Aidenbolos/Green-Sense/Images/bme_680bb_setup.jpg

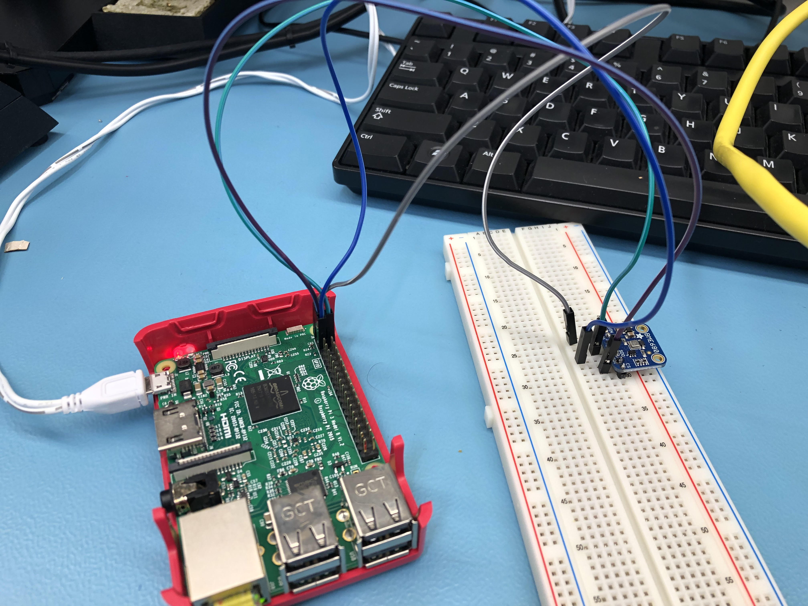
Images/bme_680bb_setup.jpg
