Aidenbolos/Green-Sense/Images/Greenhouse Frame/GreenhouseFrameStep3.jpg

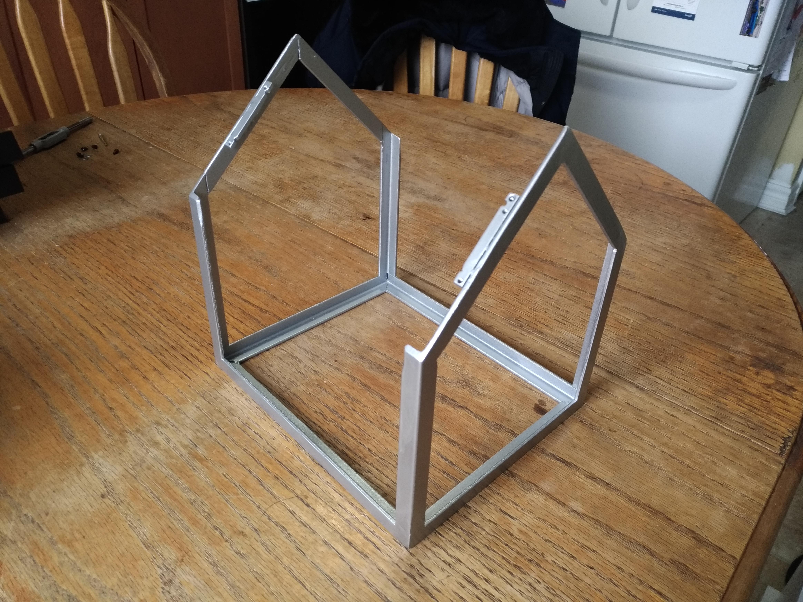
Images/Greenhouse Frame/GreenhouseFrameStep3.jpg
