Aidenbolos/Green-Sense/Documents/CENG 319/Meeting2Report.docx

GreenSense – RAD Technologies (Ryan, Aiden, Daniel)

CENG 319 Project – Milestone 3

Contact: Valeria from Humber Greenhouse

October 16, 2019

Second Meeting Minutes

- Returned the Argus Controls user manual that she loaned us
- Showed Valeria our PowerPoint presentation from milestone 2 (project plan, design documents, mockups, app demo)
- Valeria was pleased with the current progress and direction we are headed in
- She says we seem to have a good understanding of the greenhouse’s needs
- She liked the option to login as a staff member for a full featured app, or login as a guest for education/information
- She liked that our app is currently user friendly and easy to navigate
- She also had a few suggestions:
1. Have greenhouse 1 and greenhouse 2 accessible from within the same page instead of being separate activities (maybe use TabLayout or BottomNavigation to switch between them)
2. Have sensor readings and effector controls within the same page instead of being separate activities
3. Add the Humber logo/colour scheme somewhere within the app/main screen (this is something to consider for other college’s/greenhouses as well)
- She is looking forward to meeting again and seeing our progress
- We thanked her for her suggestions and will meet again soon
