Aidenbolos/Green-Sense/Documents/CENG 319/Current Work Progress Report.docx

Current Work Progress Report

(R.A.D. Technologies Greenhouse System Project)

As of the first milestone (October 8th, 2019) our current progress on the project has been as follows:

- Had first meeting with sponsor; Valeria from the Humber Greenhouse
- Established a name and icon for the application
- Multiple resolutions for the icon and other images used
- Entry level mockups completed
- Requirement Analysis completed
- Defined current tools that have been used and/or tools that will be used
- We have a minimum of 3 java classes started
- The current version of the app runs on a device and an emulator
- Completed report from the first meeting with the sponsor
- We have a completed Project Plan and Gantt Chart
- Completed Design documents and Architecture Diagrams

We have plans to start working and developing the app for future releases as well as to start setting up a backend system that will eventually read in data from our sensors from the hardware of the unit to allow for real time, accurate readings of a greenhouse system.
