Aidenbolos/Green-Sense/Mechanical/Greenhouse Frame/GreenhouseFrameSketches.pdf

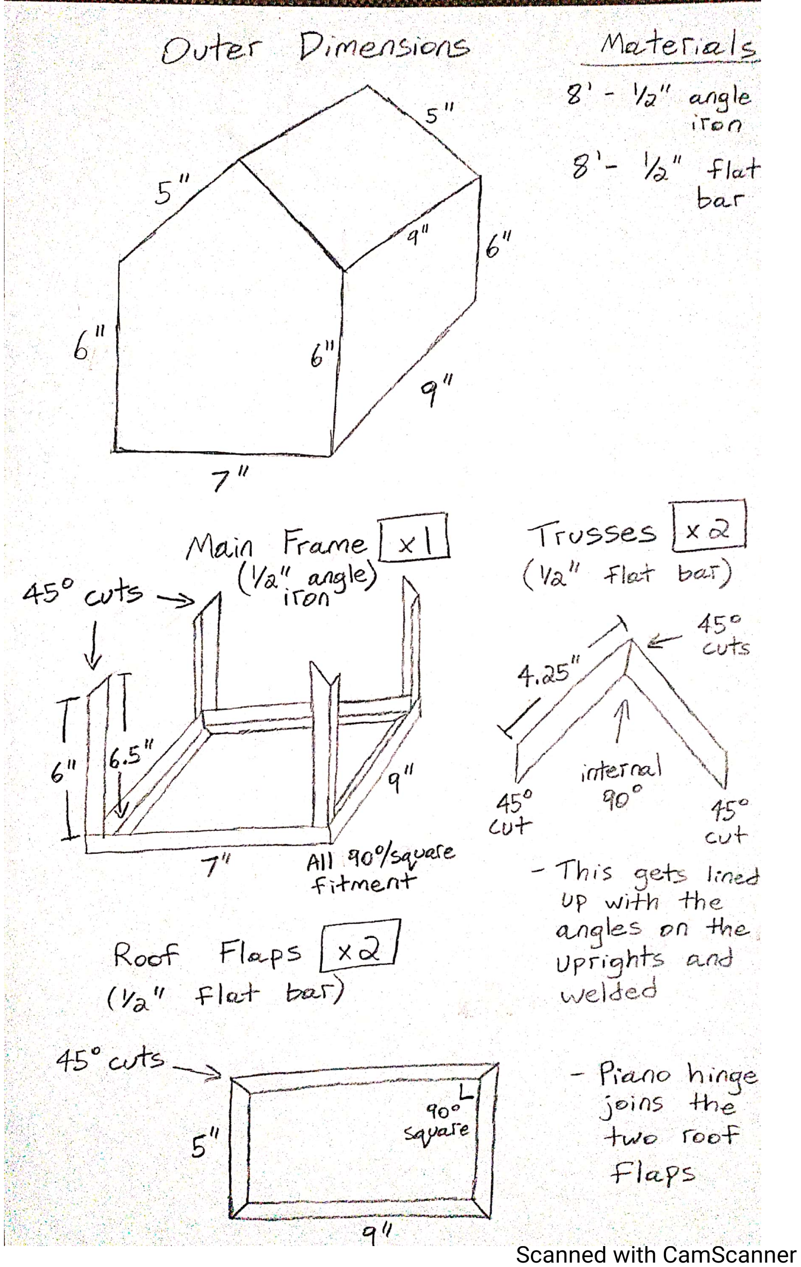
[picture p29: page 1]
