Aidenbolos/Green-Sense/GreenSenseApp/src/main/ic_launcher-web.png

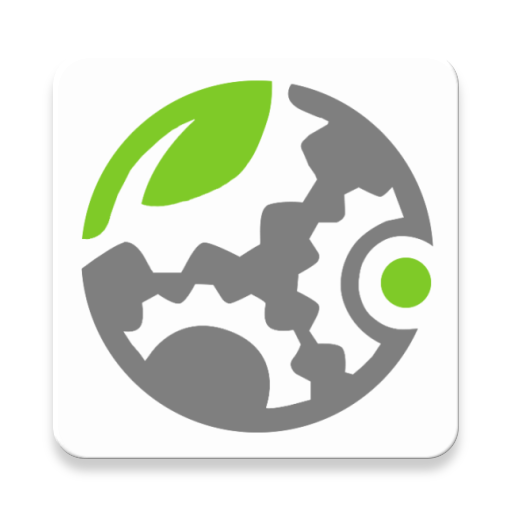
GreenSenseApp/src/main/ic_launcher-web.png
