Aidenbolos/Green-Sense/Images/AppControlScreen2020.PNG

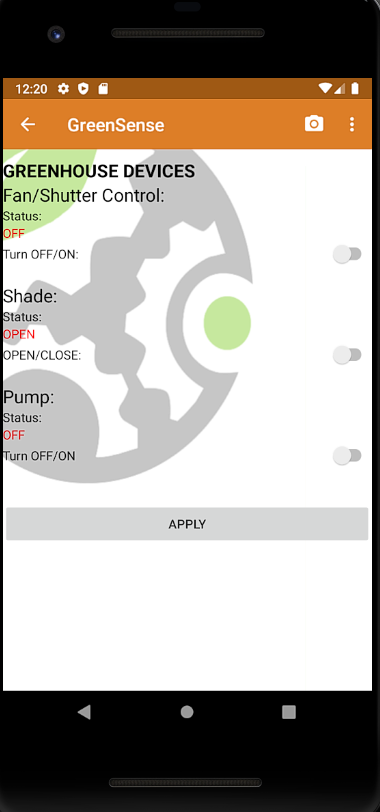
Images/AppControlScreen2020.PNG
