Aidenbolos/Green-Sense/Images/AppMainScreen2020.PNG

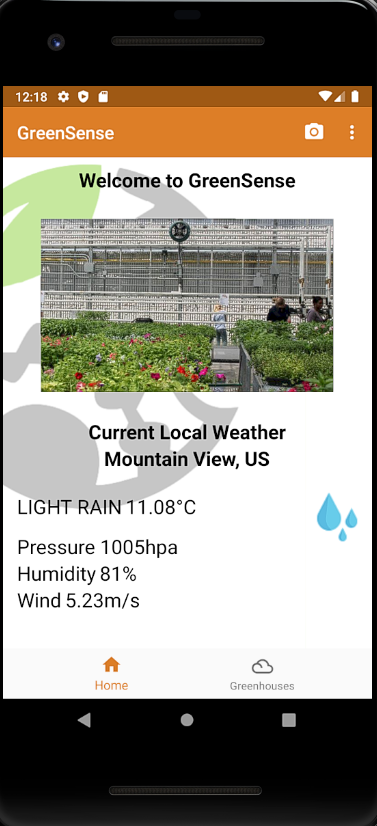
Images/AppMainScreen2020.PNG
