Aidenbolos/Green-Sense/Images/AppReadingsScreen2020.PNG

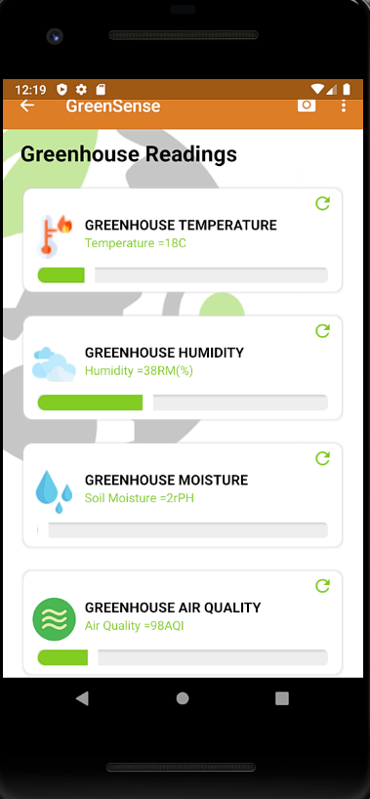
Images/AppReadingsScreen2020.PNG
