Aidenbolos/Green-Sense/Images/AppViewScreen2020.PNG

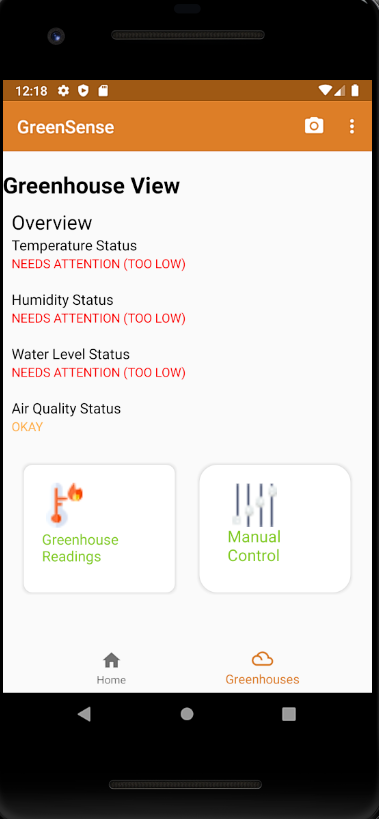
Images/AppViewScreen2020.PNG
