Aidenbolos/Green-Sense/Images/BME680_pcb.png

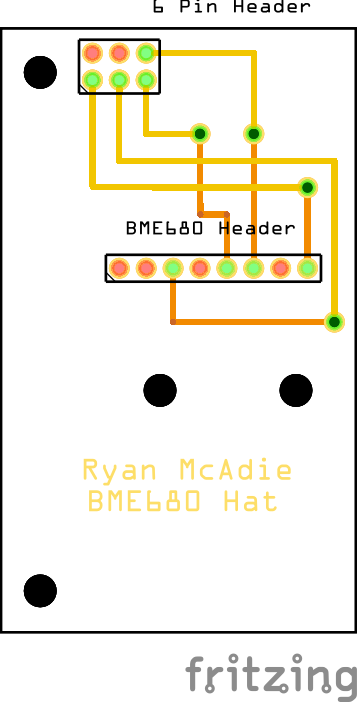
Images/BME680_pcb.png
