Aidenbolos/Green-Sense/Images/Greenhouse Frame/GreenhouseRoof1.jpg

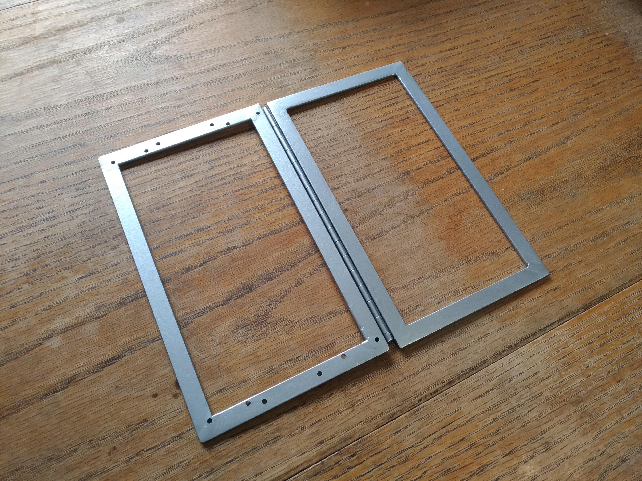
Images/Greenhouse Frame/GreenhouseRoof1.jpg
