Aidenbolos/Green-Sense/Images/Greenhouse Frame/GreenhouseRoof2.jpg

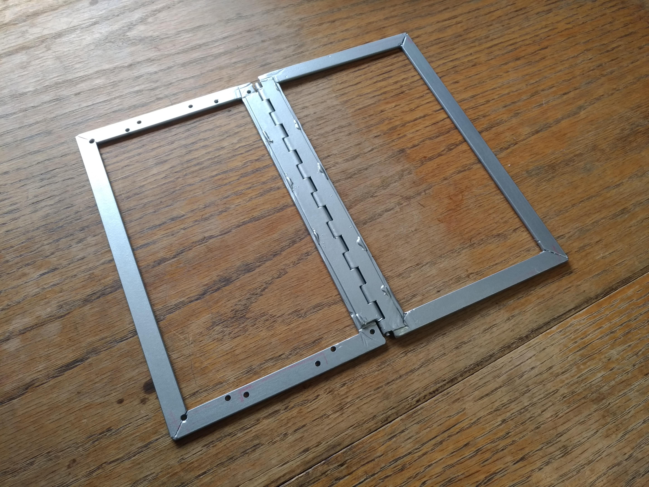
Images/Greenhouse Frame/GreenhouseRoof2.jpg
