Aidenbolos/Green-Sense/Images/Greenhouse Frame/GreenhouseRoof3.jpg

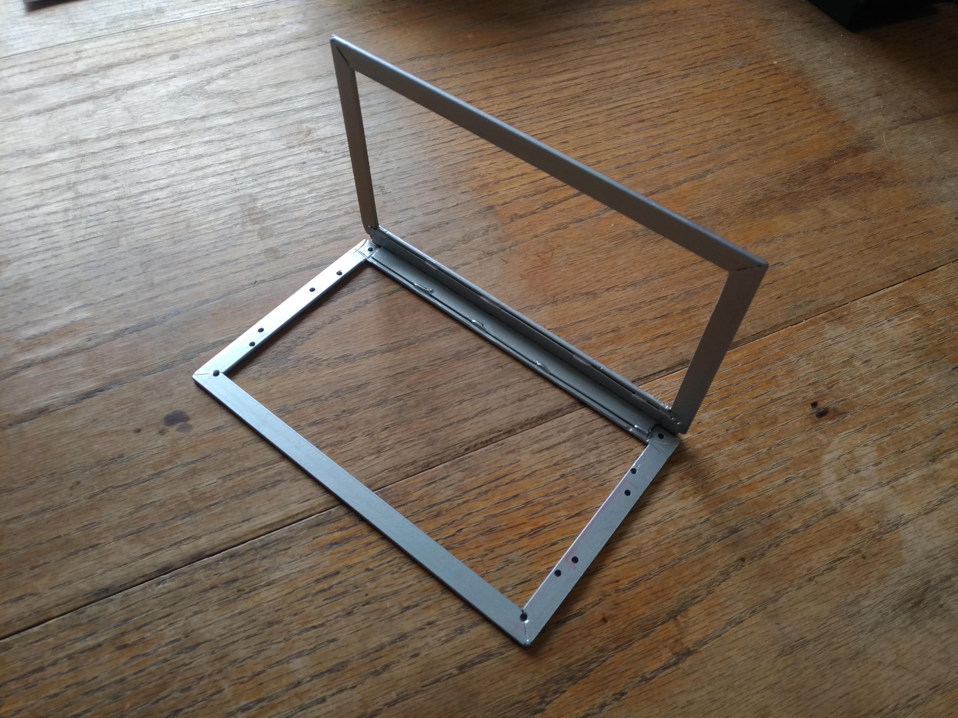
Images/Greenhouse Frame/GreenhouseRoof3.jpg
