Aidenbolos/Green-Sense/Images/GreenSenseCollabFinal_pcb.png

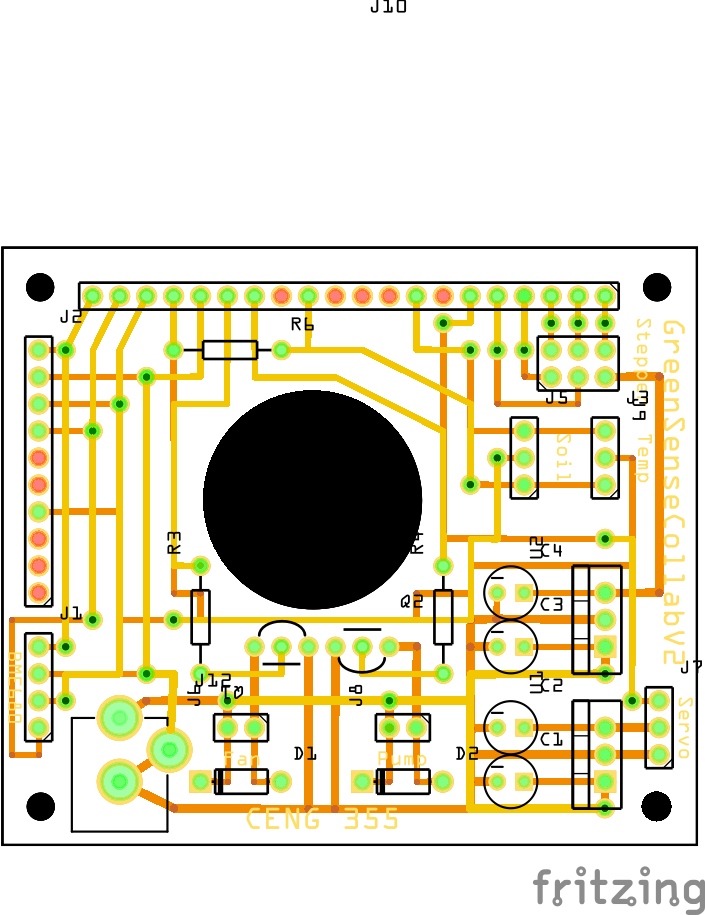
Images/GreenSenseCollabFinal_pcb.png
