Aidenbolos/Green-Sense/Images/GreenSenseSideboard_pcb.png

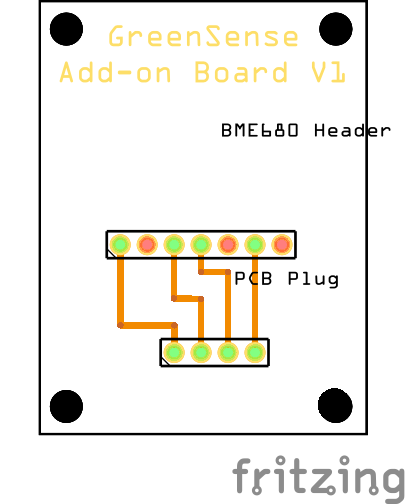
Images/GreenSenseSideboard_pcb.png
