Aidenbolos/Green-Sense/Images/Mockups/2.jpg

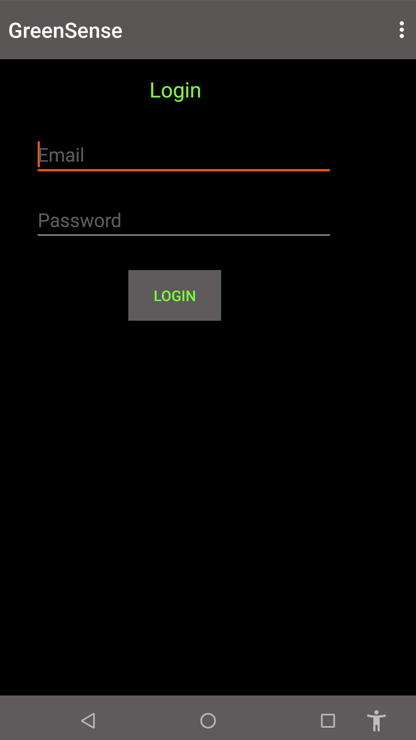
Images/Mockups/2.jpg
