Aidenbolos/Green-Sense/Images/Mockups/3.jpg

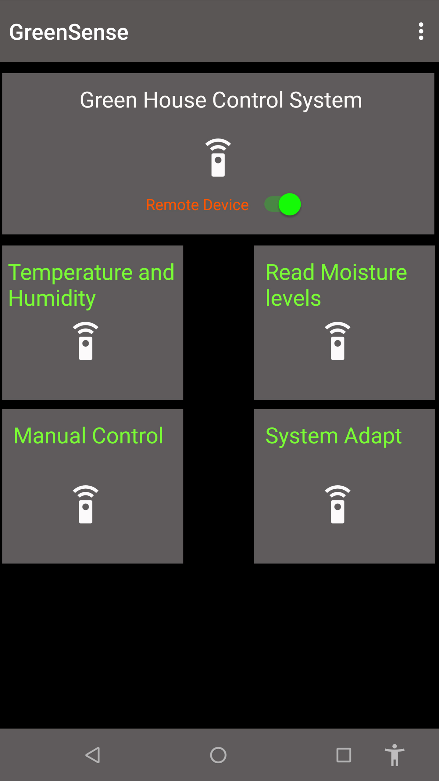
Images/Mockups/3.jpg
