Aidenbolos/Green-Sense/Images/Mockups/4.jpg

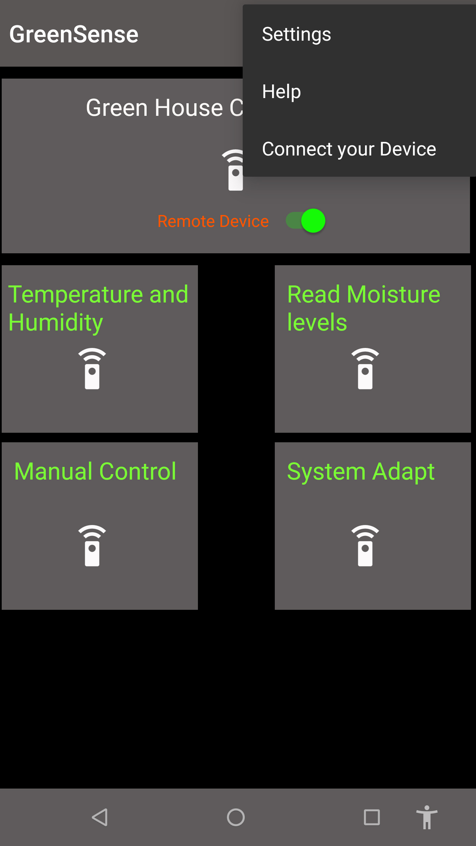
Images/Mockups/4.jpg
