Aidenbolos/Green-Sense/Images/Mockups/5.jpg

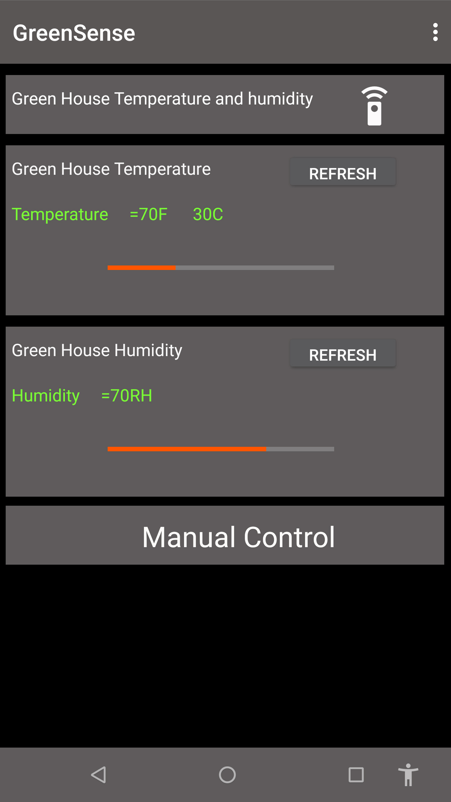
Images/Mockups/5.jpg
