Aidenbolos/Green-Sense/Images/Mockups/6.jpg

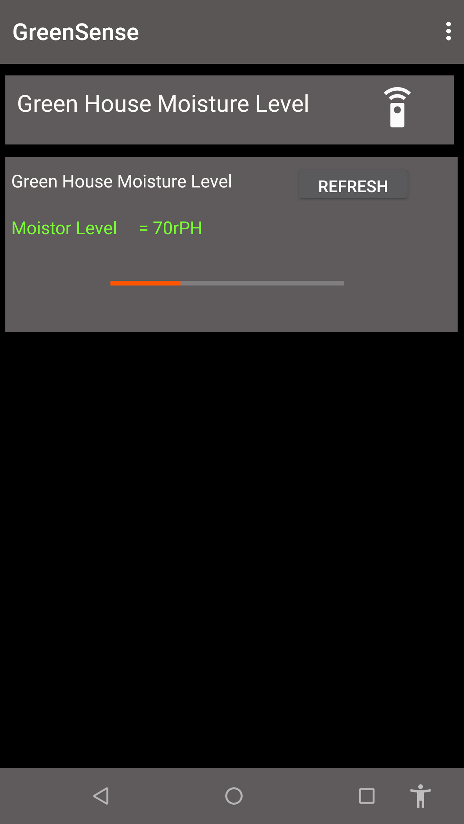
Images/Mockups/6.jpg
