Aidenbolos/Green-Sense/Images/Mockups/7.jpg

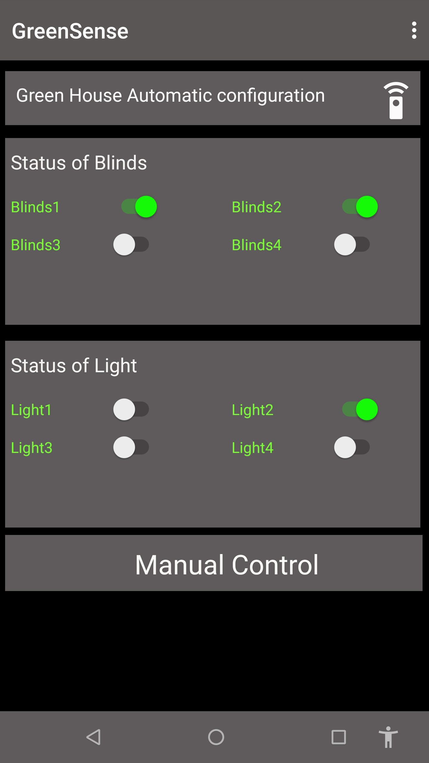
Images/Mockups/7.jpg
