Aidenbolos/Green-Sense/Images/Mockups/8.jpg

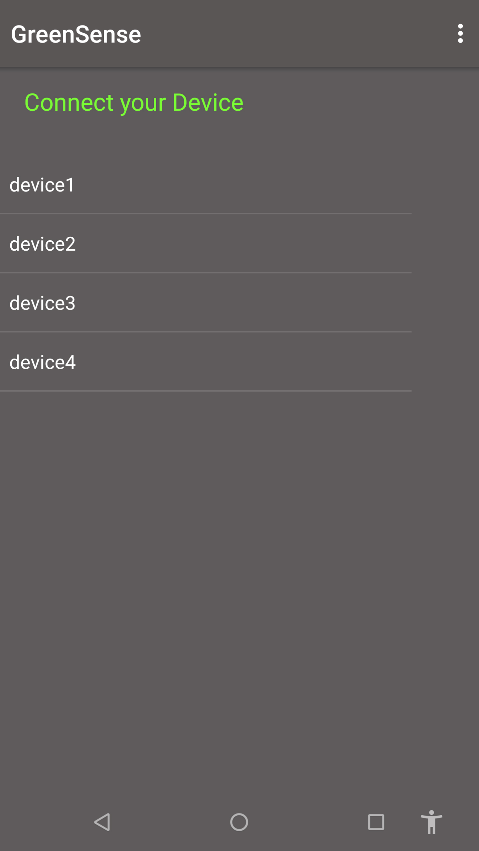
Images/Mockups/8.jpg
