Aidenbolos/Green-Sense/Images/Pi Case + PCB/pcb_sideview.jpg

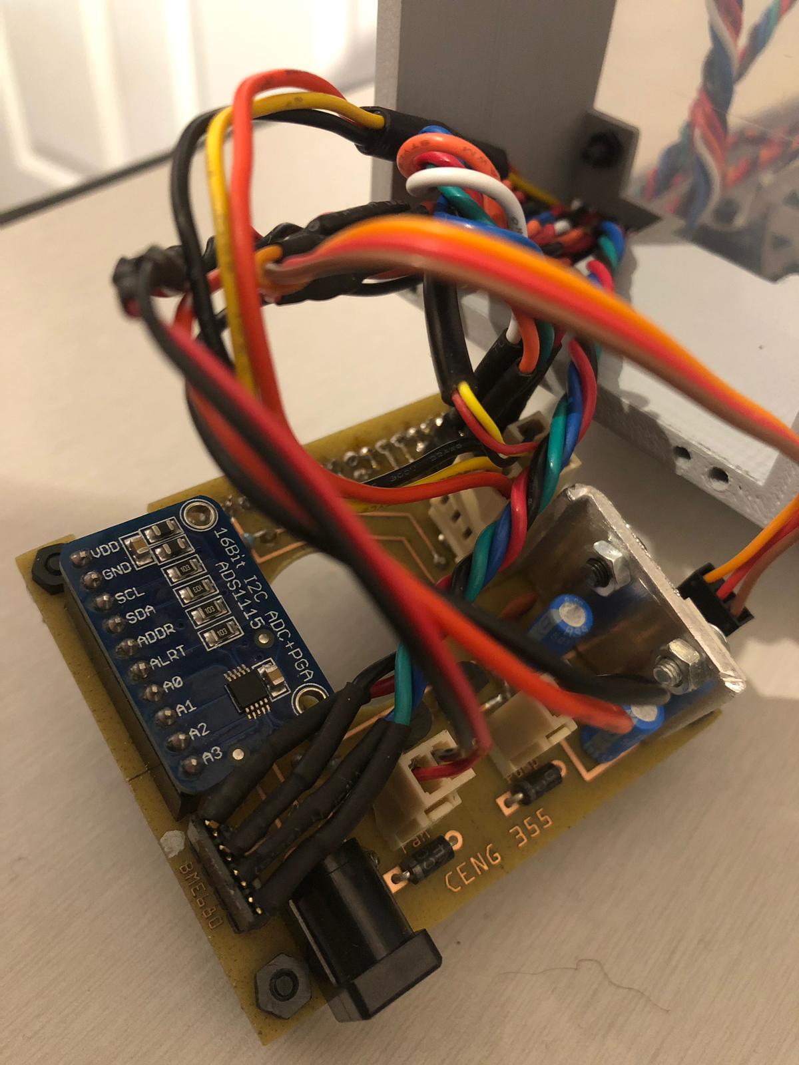
Images/Pi Case + PCB/pcb_sideview.jpg
