Aidenbolos/Green-Sense/Images/Pi Case + PCB/pcb_topview.jpg

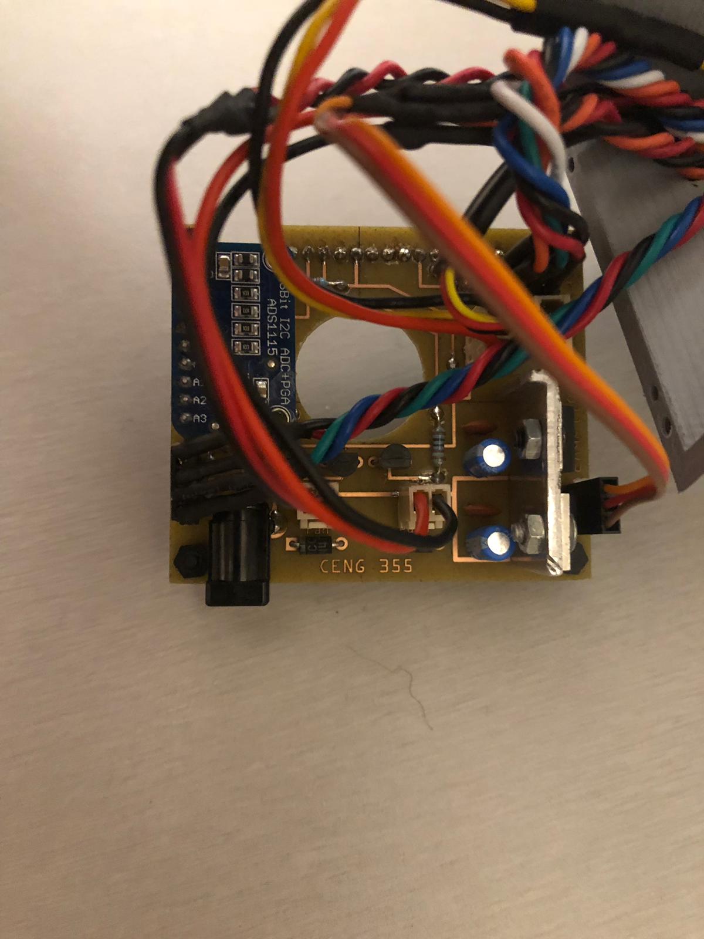
Images/Pi Case + PCB/pcb_topview.jpg
