Aidenbolos/Green-Sense/Images/Pi Case + PCB/pi_case_top.jpeg

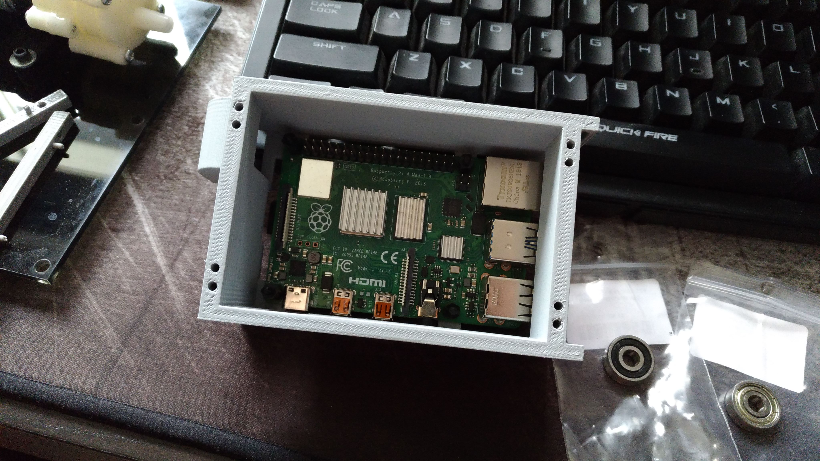
Images/Pi Case + PCB/pi_case_top.jpeg
