Aidenbolos/Green-Sense/Images/Shade System/bearing_mounts.jpg

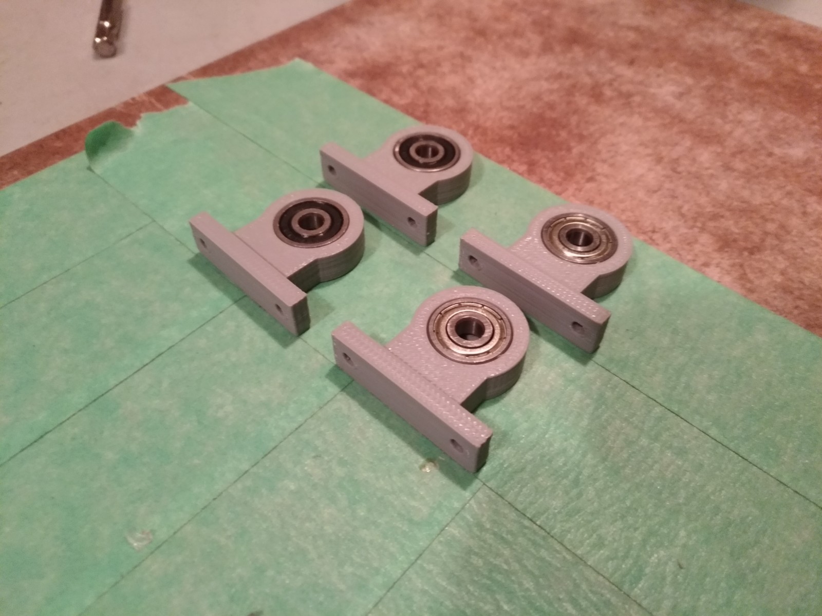
Images/Shade System/bearing_mounts.jpg
