Aidenbolos/Green-Sense/Images/Shade System/stepper_housing_closed.jpeg

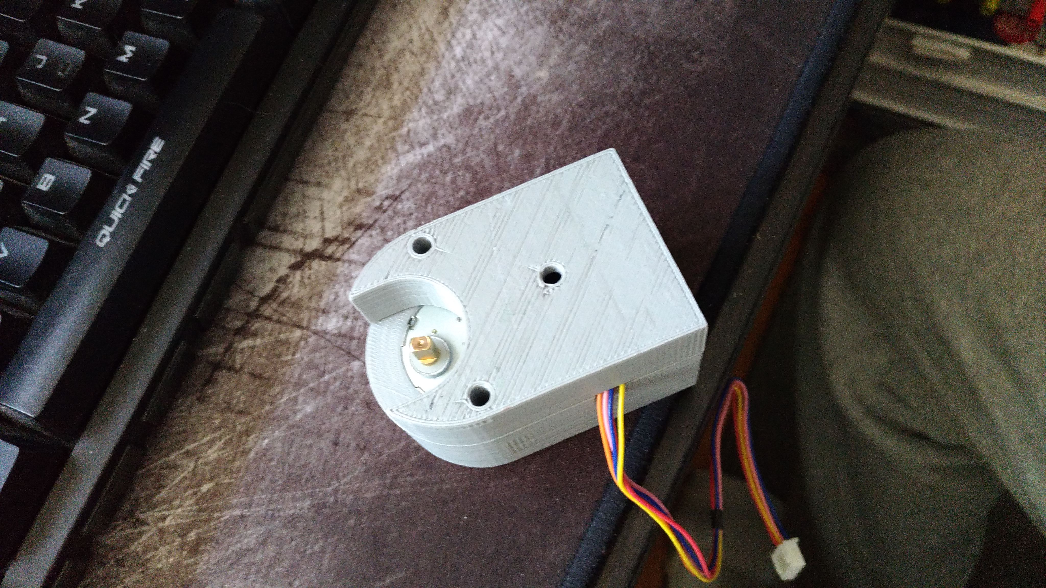
Images/Shade System/stepper_housing_closed.jpeg
