Aidenbolos/Green-Sense/Images/Shade System/stepper_housing_open.jpeg

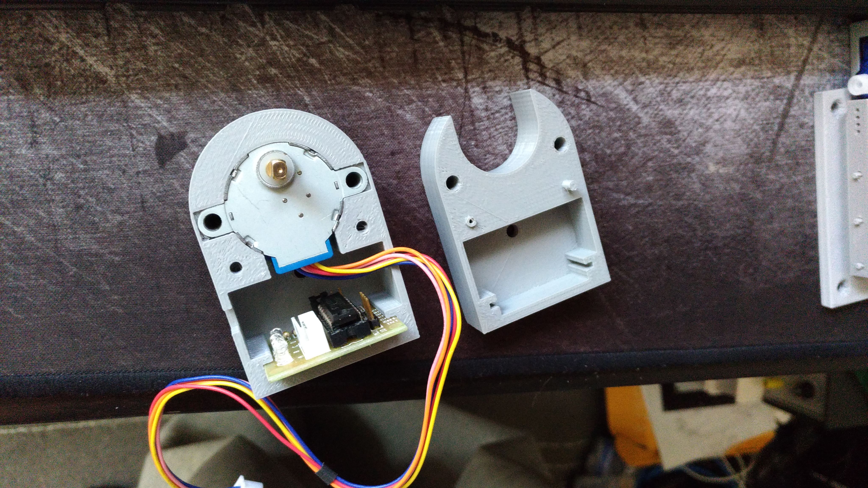
Images/Shade System/stepper_housing_open.jpeg
