Aidenbolos/Green-Sense/Images/Shutter System/pi_case+shutter.jpg

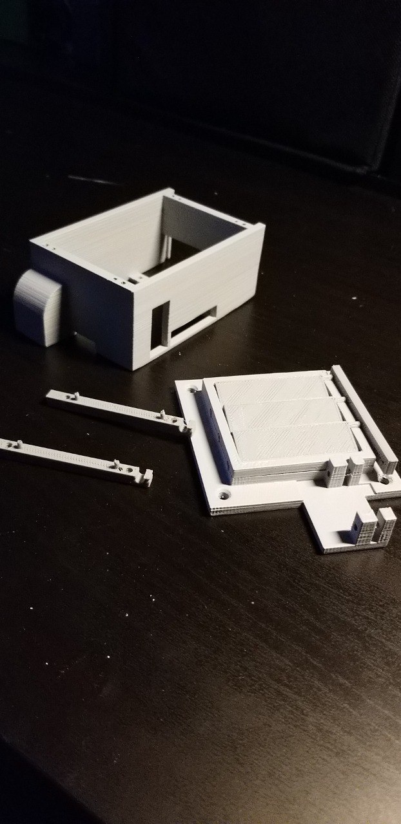
Images/Shutter System/pi_case+shutter.jpg
