Aidenbolos/Green-Sense/Images/Shutter System/shutter_servo.jpg

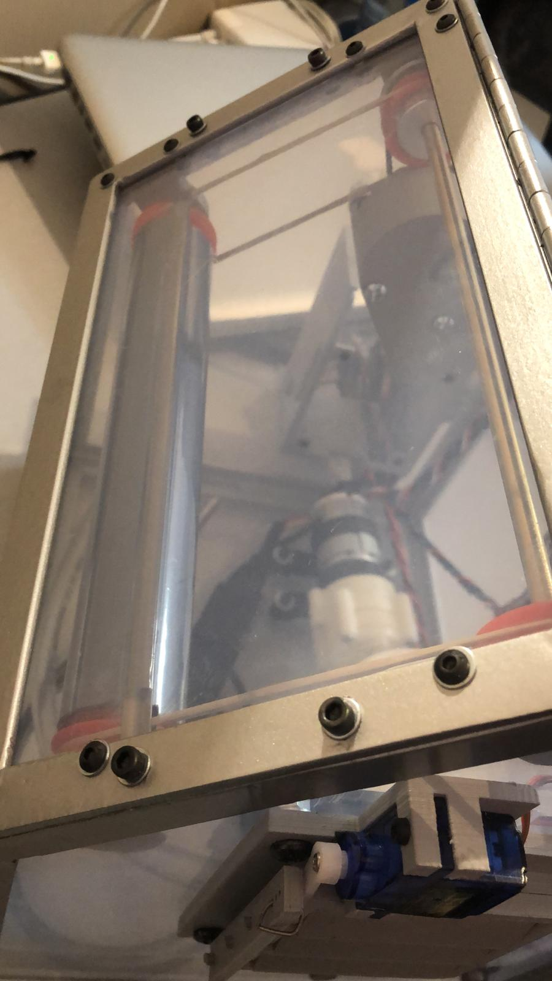
Images/Shutter System/shutter_servo.jpg
