Aidenbolos/Green-Sense/Mechanical/Fan Shroud/FanShroud (complete view).stl

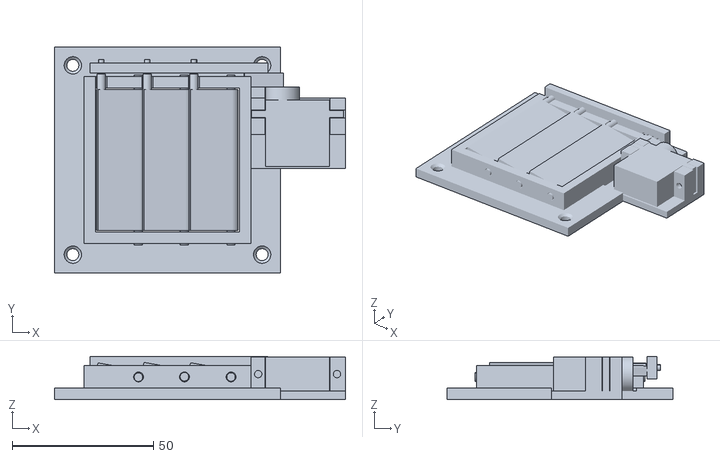
[picture p56: CAD file, 2020-03-15]
Mechanical/Fan Shroud/FanShroud (complete view).stl
103.0 x 80.0 x 15.2
