Aidenbolos/Green-Sense/Mechanical/5mm Bearing Mounts/BearingMounts.stl

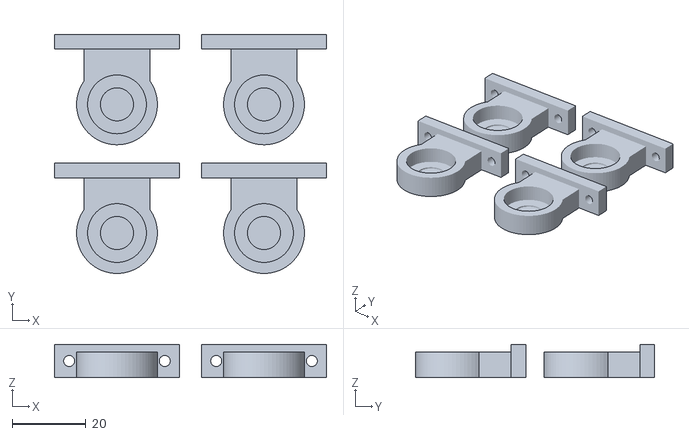
[picture p57: CAD file, 2020-03-19]
Mechanical/5mm Bearing Mounts/BearingMounts.stl
74.0 x 65.0 x 9.00
