Aidenbolos/Green-Sense/Mechanical/Fan Shroud/FanMechParts (for printing).stl

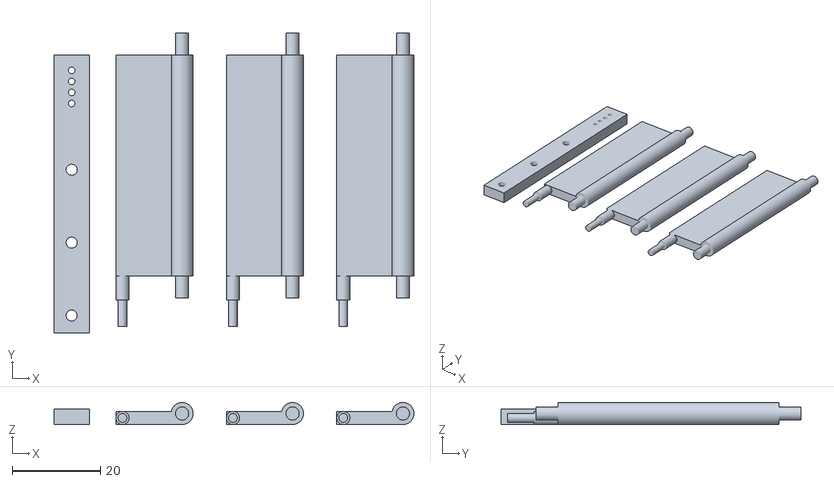
[picture p58: CAD file, 2020-03-15]
Mechanical/Fan Shroud/FanMechParts (for printing).stl
81.5 x 68.0 x 5.00
