Aidenbolos/Green-Sense/Mechanical/Pi Case/GreenSensePiCaseCaps.stl

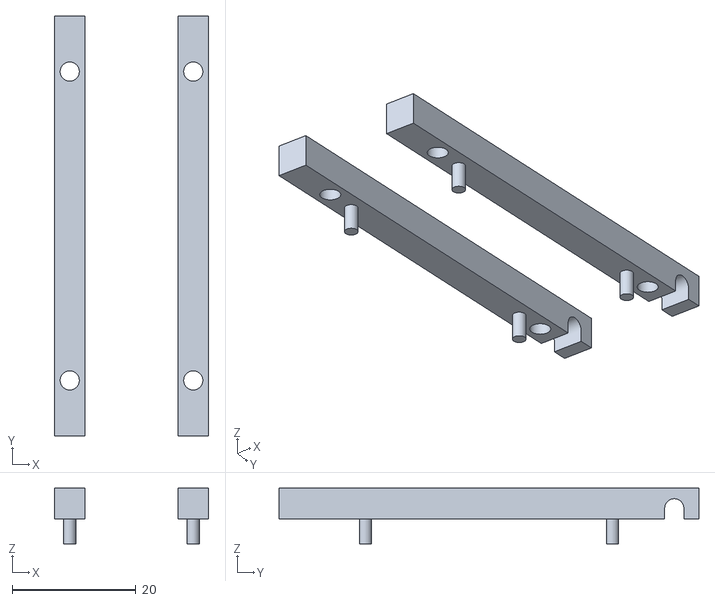
[picture p59: CAD file, 2020-03-17]
Mechanical/Pi Case/GreenSensePiCaseCaps.stl
25.0 x 68.0 x 9.00
