Aidenbolos/Green-Sense/Mechanical/Stepper Motor Mount/StepperMotorMount.stl

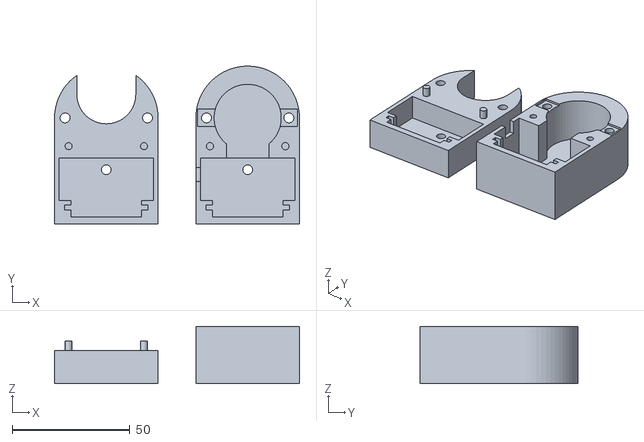
[picture p60: CAD file, 2020-03-19]
Mechanical/Stepper Motor Mount/StepperMotorMount.stl
104.0 x 67.0 x 24.2
