Aidenbolos/Green-Sense/Mechanical/Pi Case/GreenSensePiCase.stl

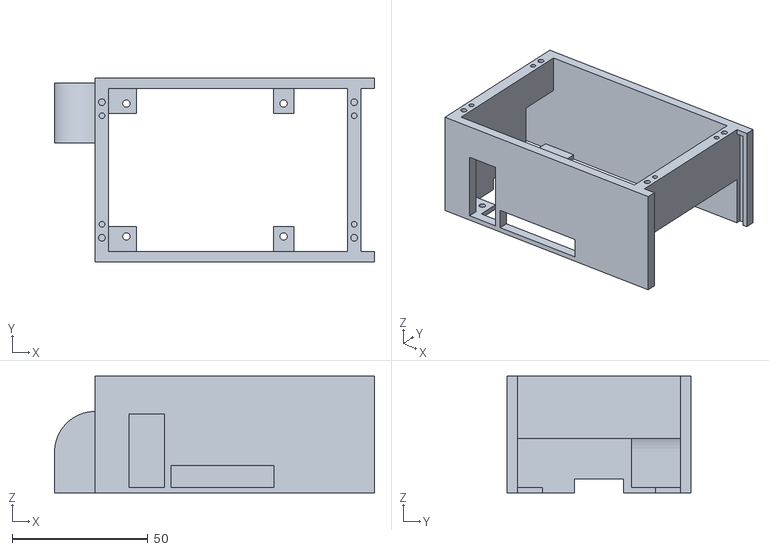
[picture p61: CAD file, 2020-03-17]
Mechanical/Pi Case/GreenSensePiCase.stl
118.0 x 68.0 x 43.0
