Aidenbolos/Green-Sense/Mechanical/Fan Shroud/FanShroudParts (for printing).stl

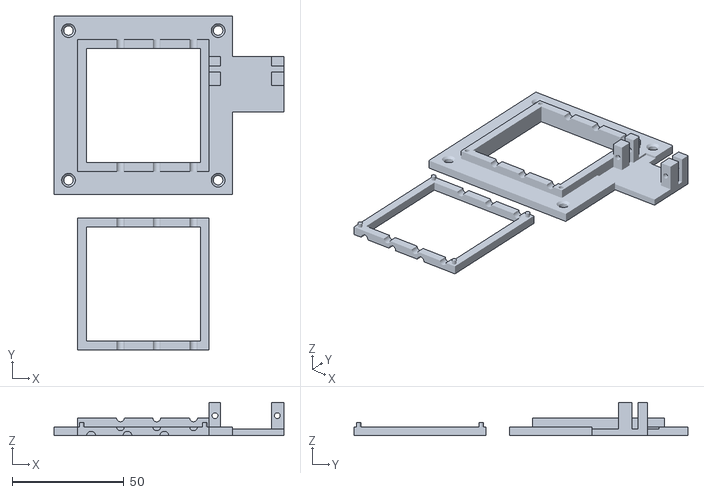
[picture p62: CAD file, 2020-03-15]
Mechanical/Fan Shroud/FanShroudParts (for printing).stl
103.0 x 149.5 x 15.0
