Aidenbolos/Green-Sense/(list of files, cad)

Other CAD files:
Mechanical/Fan Shroud/FanShroudParts.scad
