Aidenbolos/Green-Sense/Images/Greenhouse Frame/GreenhouseFrameStep1.jpeg

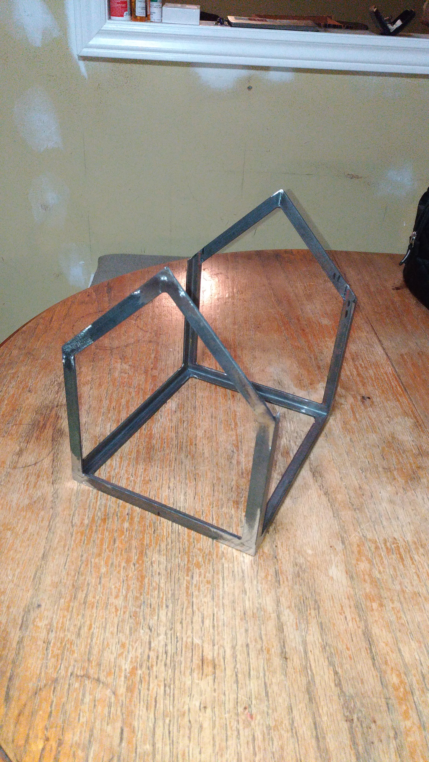
Images/Greenhouse Frame/GreenhouseFrameStep1.jpeg
