Aidenbolos/Green-Sense/Images/Greenhouse Frame/GreenhouseFrameStep4.jpg

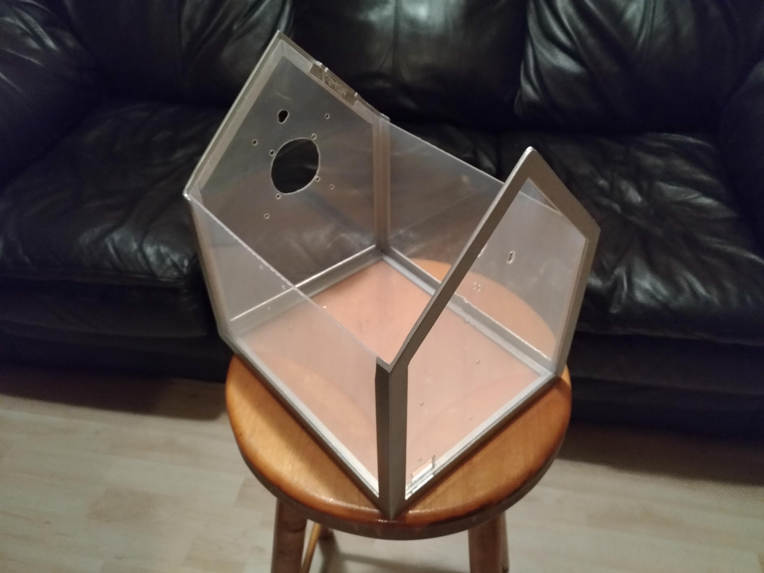
Images/Greenhouse Frame/GreenhouseFrameStep4.jpg
