Aidenbolos/Green-Sense/Images/Greenhouse Frame/GreenhouseFrameStep5.jpg

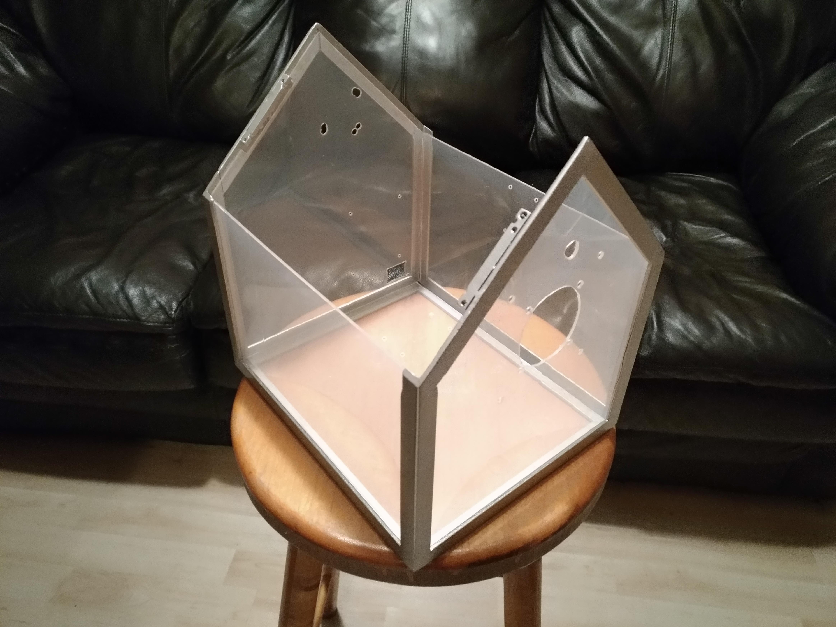
Images/Greenhouse Frame/GreenhouseFrameStep5.jpg
