Aidenbolos/Green-Sense/Images/1kResistor-Test.jpg

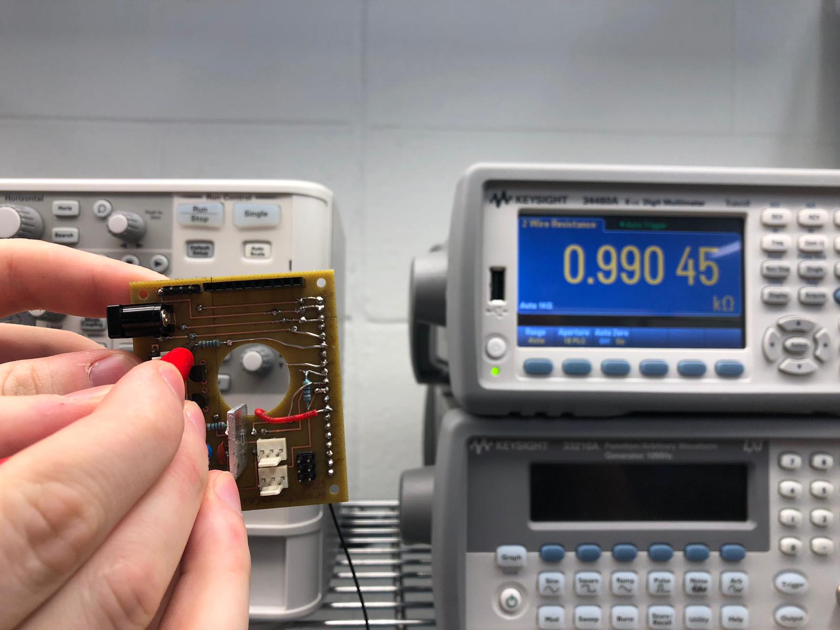
Images/1kResistor-Test.jpg
