Aidenbolos/Green-Sense/Images/3v3Power-Test.jpg

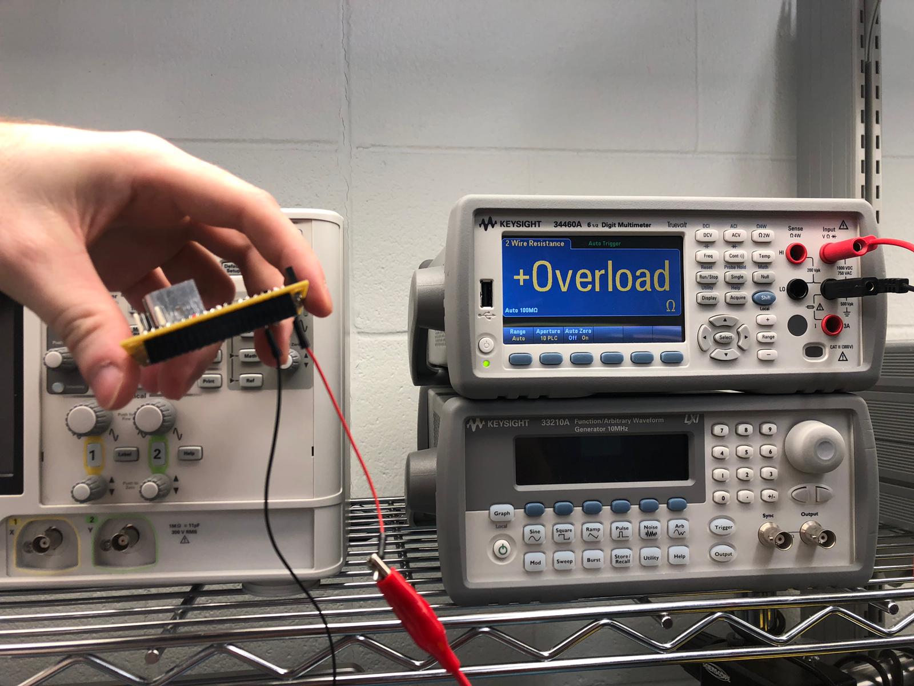
Images/3v3Power-Test.jpg
