Aidenbolos/Green-Sense/Images/9vPower-Test.jpg

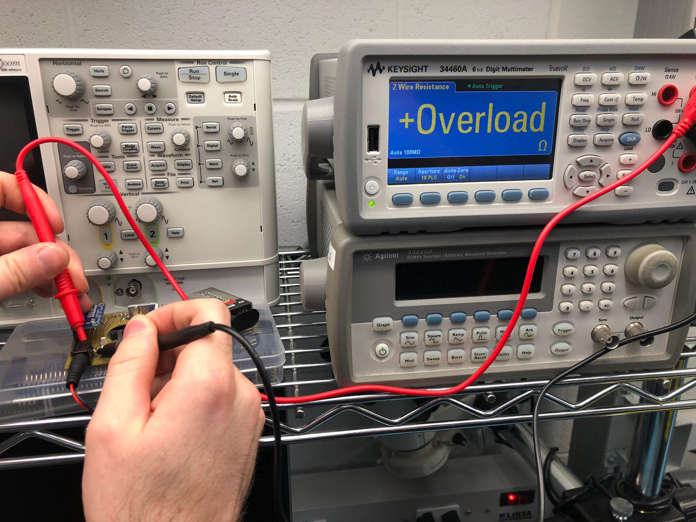
Images/9vPower-Test.jpg
