Aidenbolos/Green-Sense/Mechanical/Acrylic for Greenhouse and Pi case/GreenhouseParts1.pdf

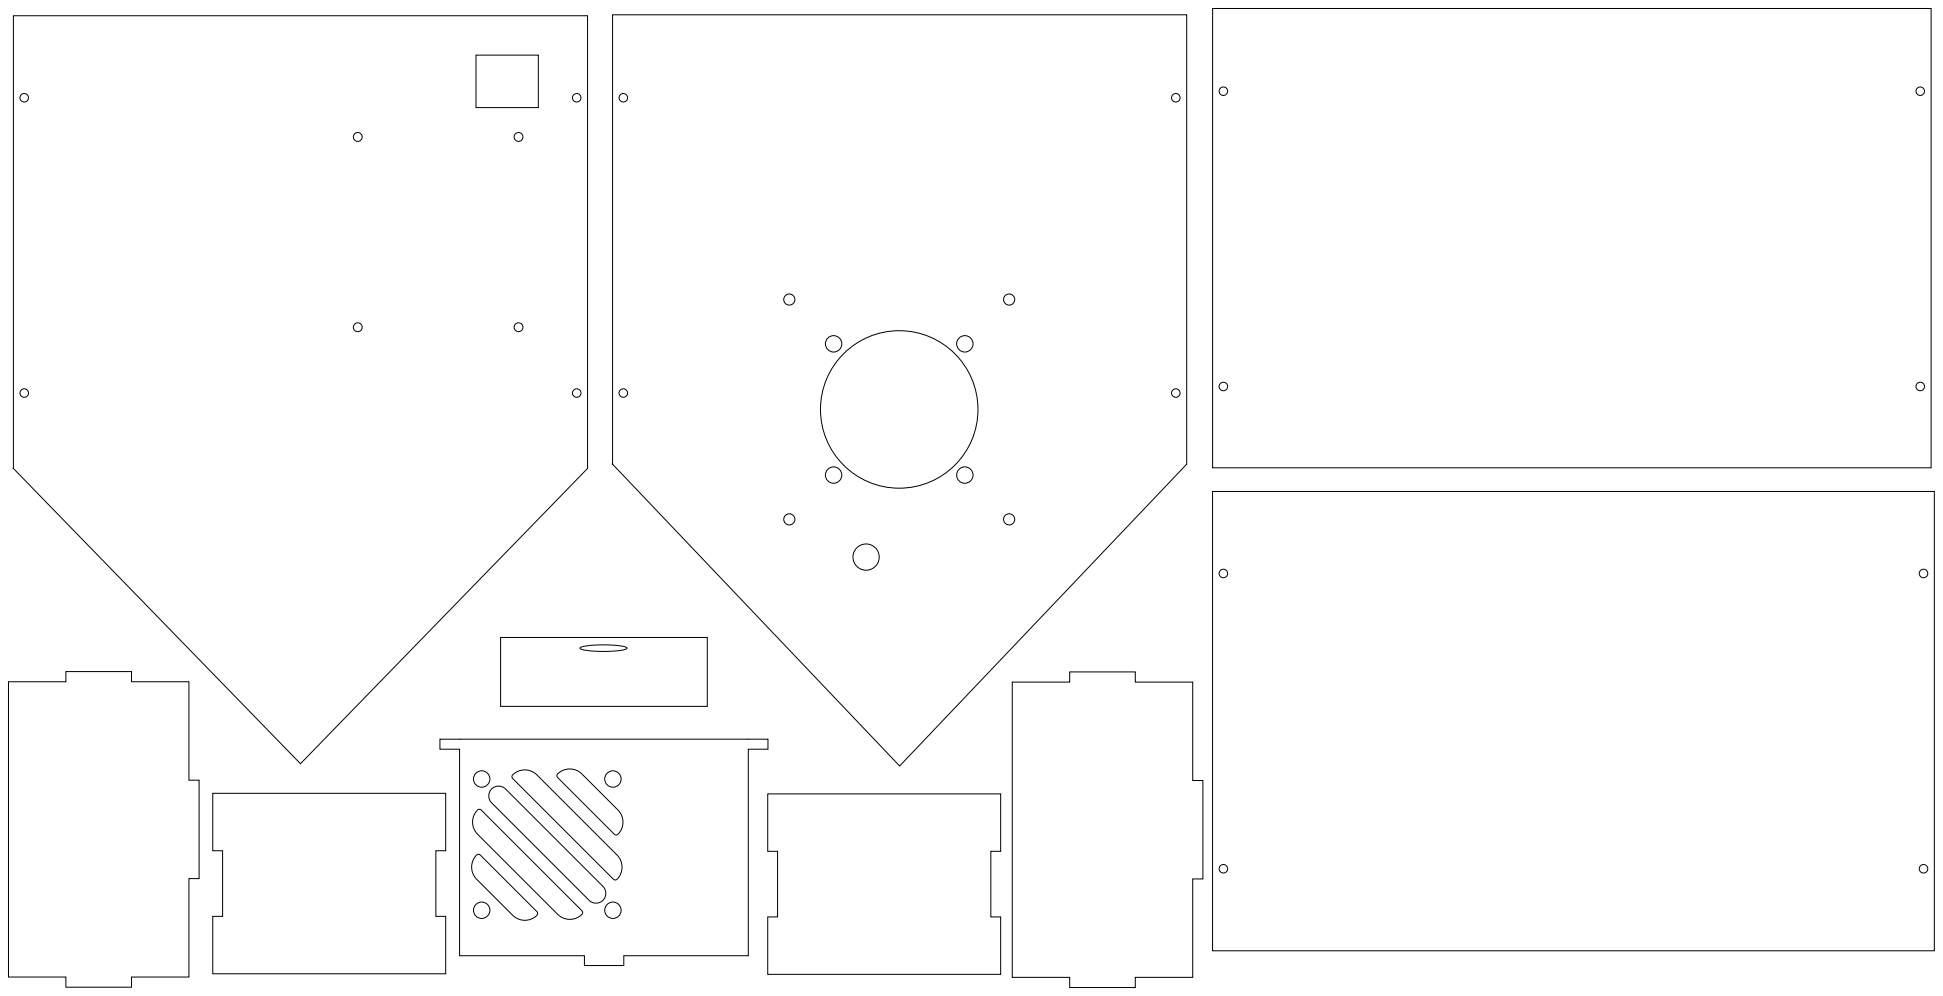
[picture p70: page 1]
