Aidenbolos/Green-Sense/Mechanical/Acrylic for Greenhouse and Pi case/GreenhouseParts2.pdf

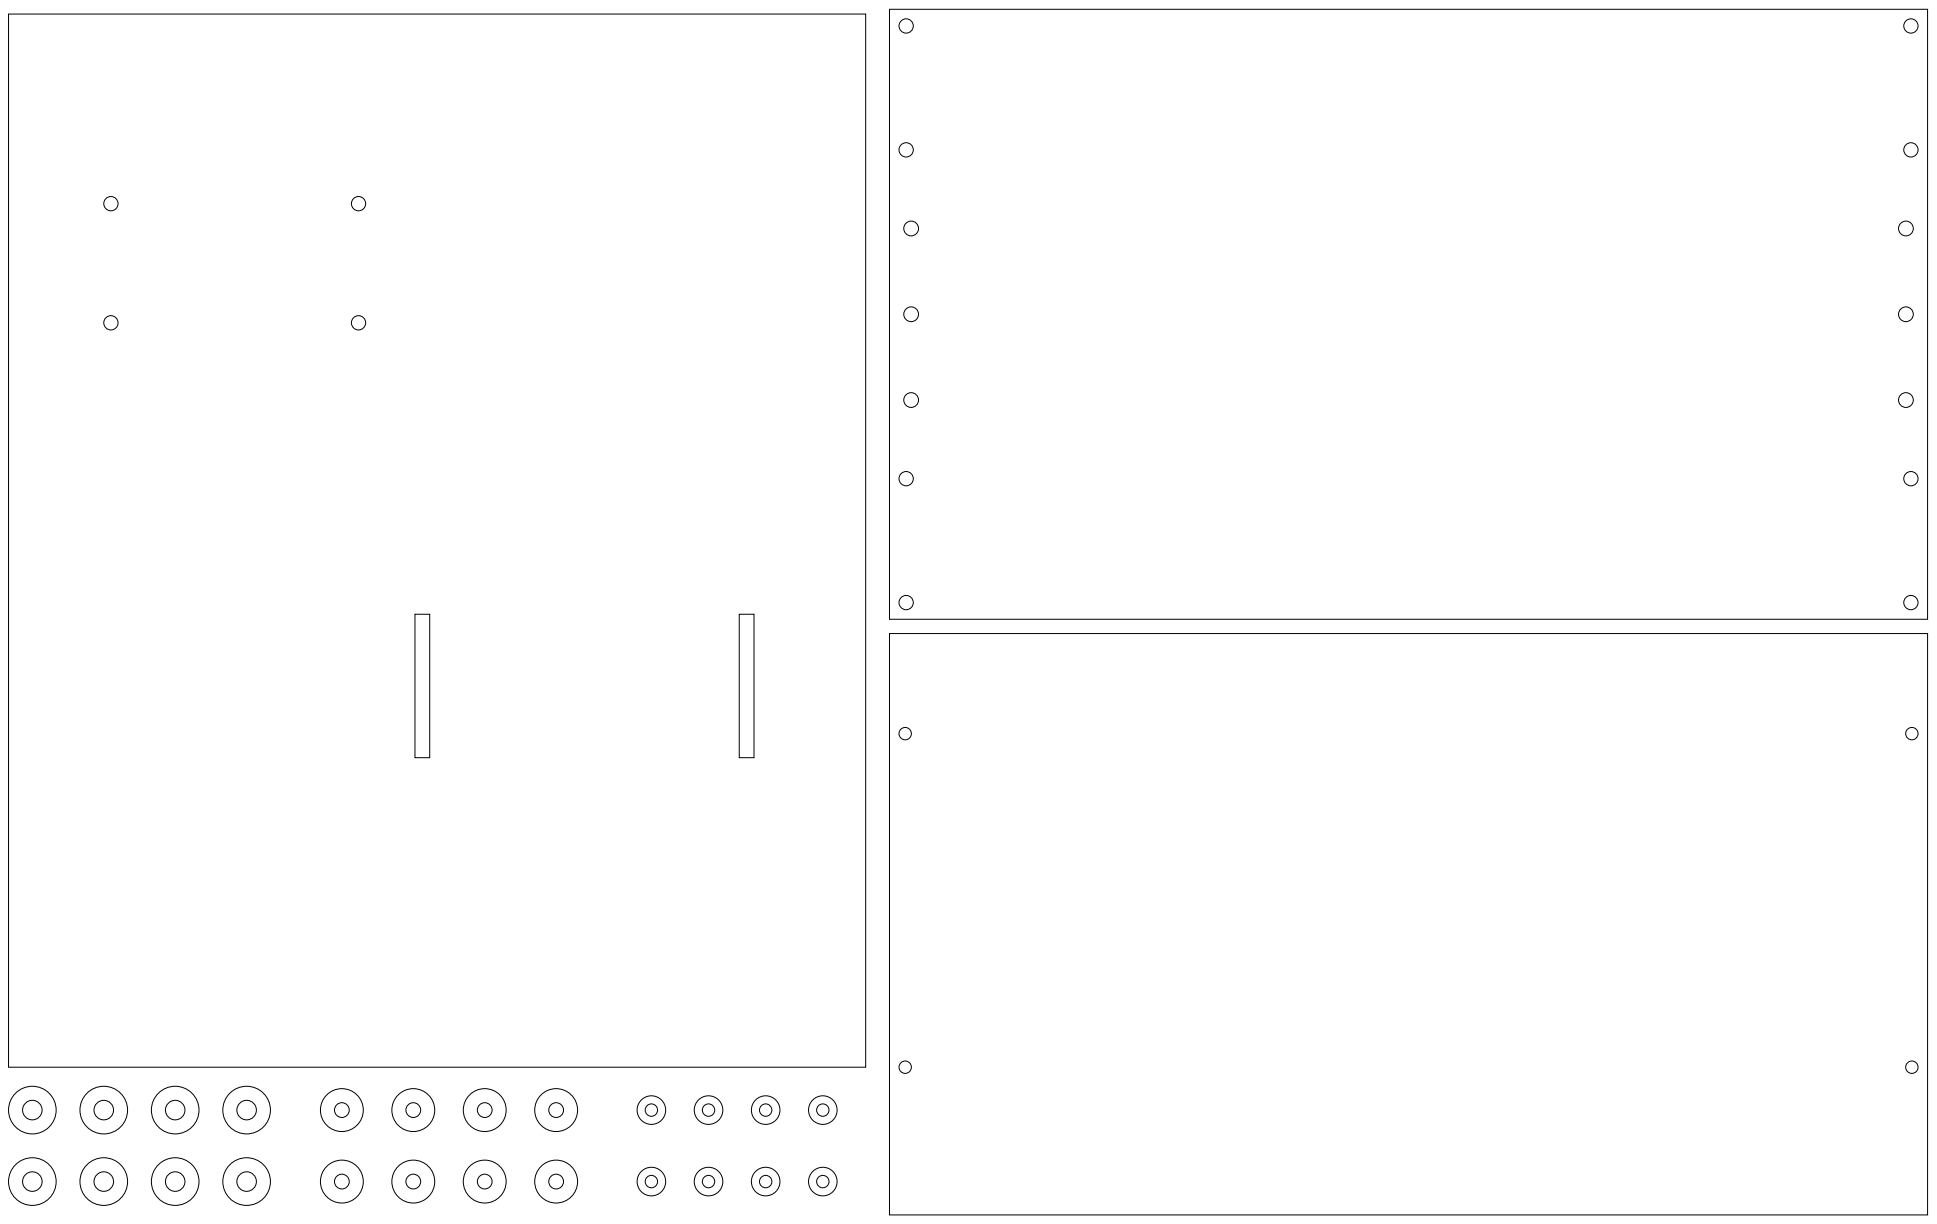
[picture p71: page 1]
