Aidenbolos/Green-Sense/Documents/CENG 319/GreenSenseDesign.pdf

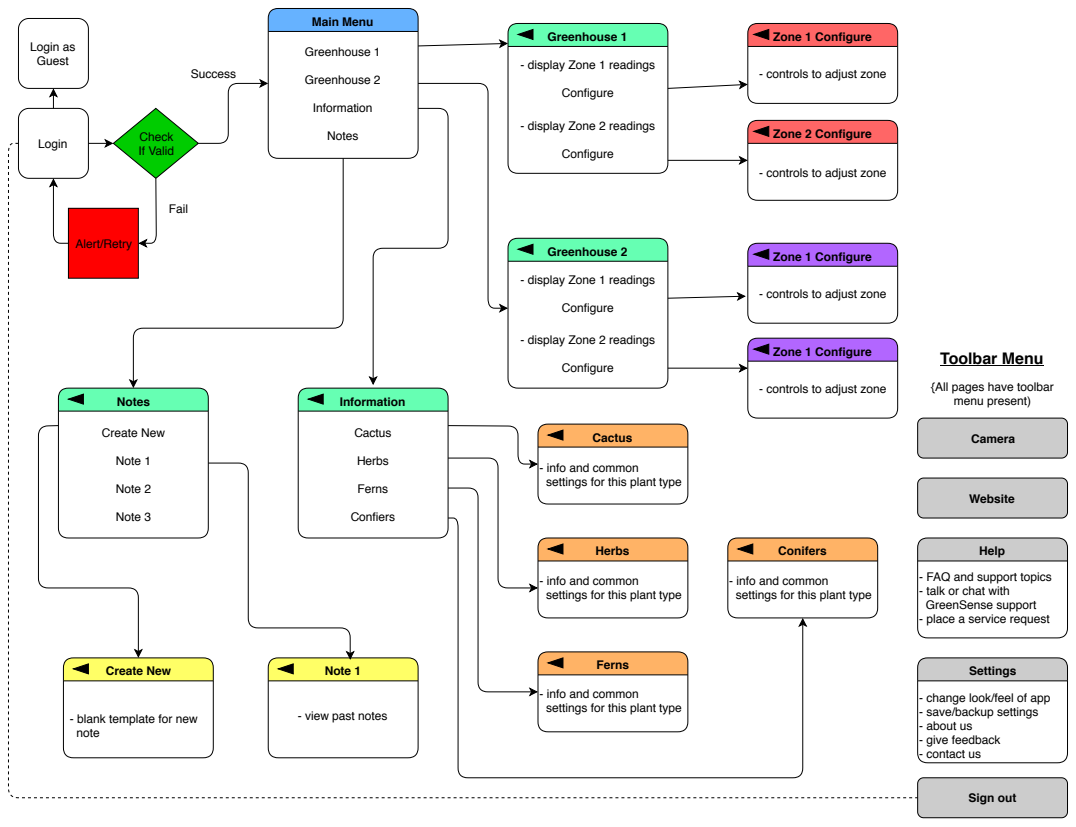
[picture p72: page 1]
Login; Check; If Valid; Alert/Retry; Login as Guest; Main Menu; Greenhouse 1; Greenhouse 2; Information; Notes; Help; Cactus; Herbs; Ferns; Confiers; Settings; Sign out; Success; Fail; Create New; Note 1; Note 2; Note 3; Configure; Website; Camera; Toolbar Menu; Zone 1 Configure; Zone 2 Configure; Conifers

- display Zone 1 readings

- controls to adjust zone

- display Zone 2 readings

{All pages have toolbar
menu present)

- info and common
settings for this plant type

- FAQ and support topics
- talk or chat with
GreenSense support
- place a service request

- change look/feel of app
- save/backup settings
- about us
- give feedback
- contact us

- blank template for new
note

- view past notes
