Aidenbolos/Green-Sense/Documents/CENG 319/GreenSenseGuestDesign.pdf

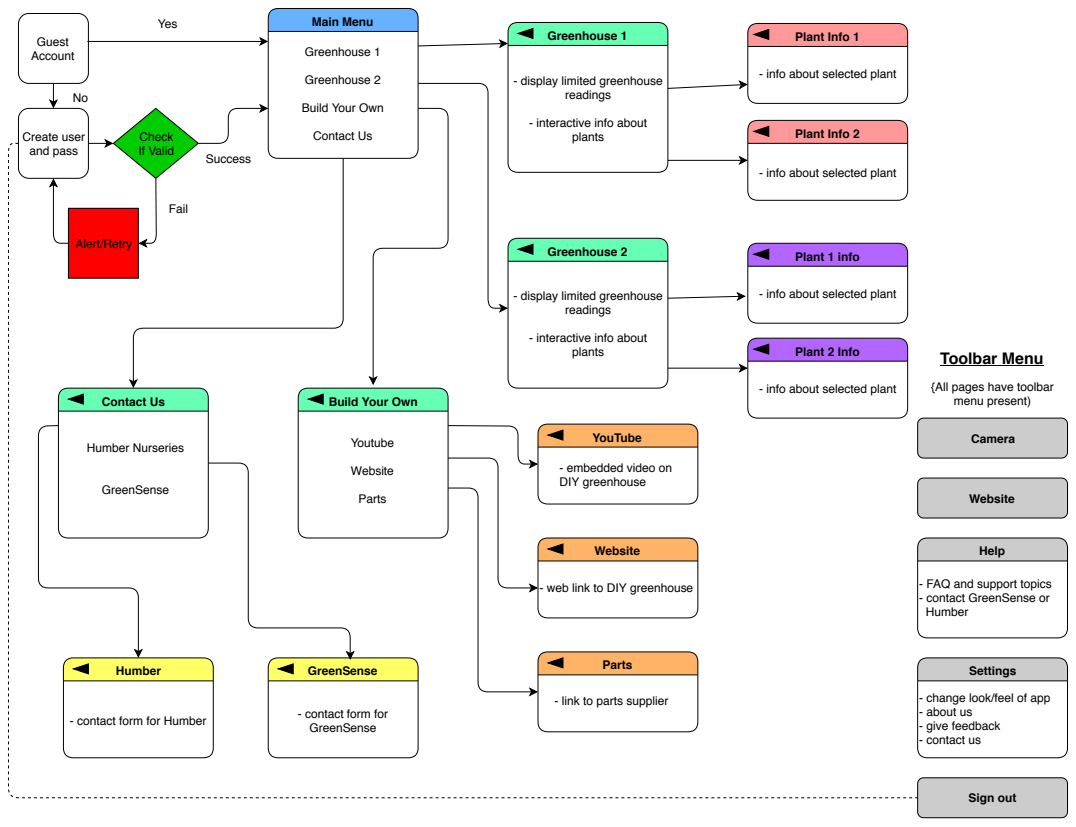
[picture p73: page 1]
Create user and pass; Check If Valid; Alert/Retry; Guest Account; Main Menu; Greenhouse 1; Greenhouse 2; Contact Us; Help; Youtube; Website; Parts; Settings; Sign out; Success; Fail; Humber Nurseries; GreenSense; readings; plants; Camera; Toolbar Menu; Plant Info 1; Plant Info 2; Plant 1 info; Plant 2 Info; YouTube; Humber; Yes

- info about selected plant

- display limited greenhouse

Build Your Own

- interactive info about

{All pages have toolbar
menu present)

- embedded video on
DIY greenhouse

- FAQ and support topics
- contact GreenSense or
Humber

- web link to DIY greenhouse

- change look/feel of app
- about us
- give feedback
- contact us

- link to parts supplier

- contact form for
GreenSense

- contact form for Humber
