Aidenbolos/Green-Sense/Documents/CENG 319/GreenSenseGantt.pdf

# GreenSenseTimeline

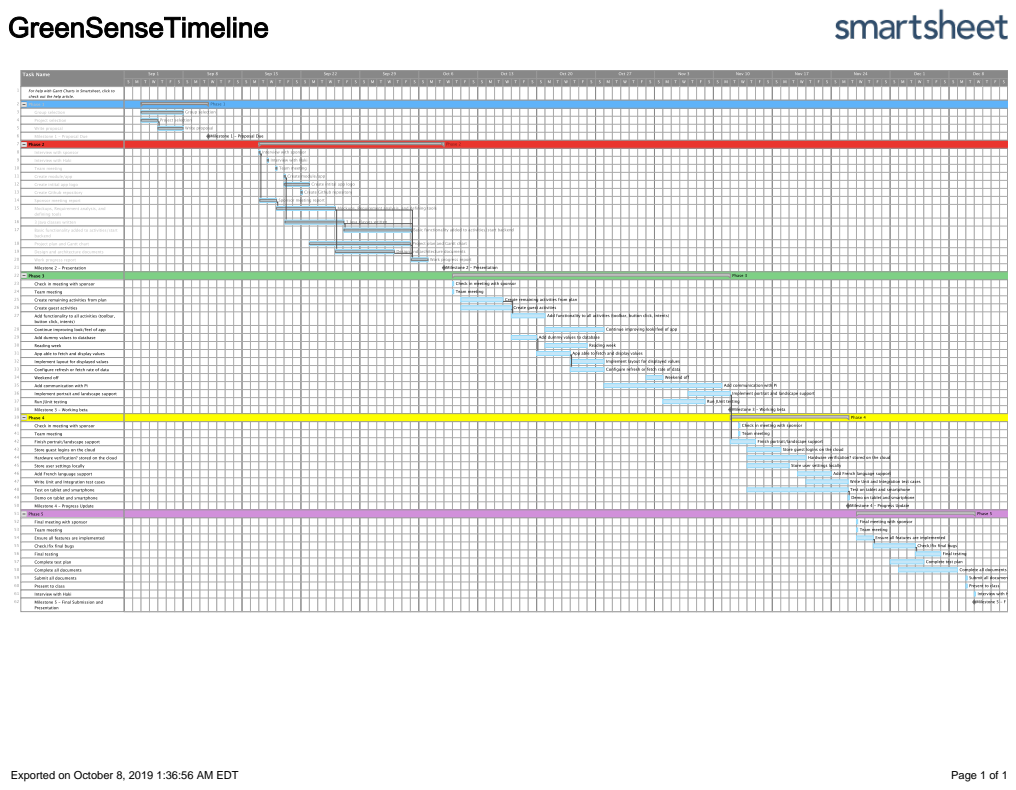
[picture p74: page 1]
Exported on October 8, 2019 1:36:56 AM EDT; Page 1 of
