Aidenbolos/Green-Sense/(list of files, drawings)

Other design files:
Electronics/BME680 PCB.fzz
Electronics/BME680.fzz
Electronics/GreenSenseCollabFinal.fzz
Electronics/GreenSenseSideboard.fzz
Electronics/Raspberry_DS18B20_temperature.fzz
Electronics/SoilMoistureFinal.fzz
Electronics/SoilMoisturePi.fzz
