Aidenbolos/Green-Sense/(commit log)

2019-10-06 1st update after initial commit: - app icon image moved to mipmap and resized - toolbar added - overflow menu added - sign out button moved to overflow - camera function added to toolbar - image/butt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
2019-10-29 Update: - changed module name to GreenSenseApp - "continue as guest" button added to login - guest activity created - guest button starts guest activity - toolbar added to all activities - up button 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
2019-11-24 Fixed up bottom nav bar, changed a few layouts to fit better as fragments. Add floating action button for adding new notes
2019-11-25 Functional guest activity pages, made login page buttons rounded
2019-12-10 - soft back key - fixed settings activity extra frag - back button for settings and about us
2019-12-10 - soft back key - removed setting extra frag - began settings functionality - back button for settings and about us
2020-02-12 Add files via upload
    DS188B20 temperature sensor
2020-02-19 ds18b20 temperature sensor
2020-02-19 Breadboard/PCB update
2020-03-06 Pics of main PCB and BME680 daughter board
2020-03-06 PCB Fritzing files and zipped Gerbers
    [GreenSenseCollabFinal.fzz, GreenSenseSideboard.fzz]
2020-03-11 Add PCB resistance test images
2020-03-14 Added 3D files for fan shroud
2020-03-15 Fan shroud 3D files
    [FanMechParts (for printing).stl, FanMechParts.scad, FanShroud (complete view).scad, FanShroud (complete view).stl, FanShroudParts (for printing).stl, FanShroudParts.scad]
2020-03-15 Create greenhouse frame file directory
2020-03-15 Add greenhouse frame picture step 1
2020-03-15 Create directory for greenhouse frame files
2020-03-15 Added greenhouse frame step 1 image
2020-03-15 Create directory for pi case files
2020-03-15 Create directory for stepper motor mount files
2020-03-17 Added Pi case design/3D files
    [GreenSensePiCase.scad, GreenSensePiCase.stl, GreenSensePiCaseCaps.scad, GreenSensePiCaseCaps.stl]
2020-03-19 Added stepper motor and driver housing 3D files
    [StepperMotorMount.scad, StepperMotorMount.stl]
2020-03-19 Created directory for bearing mount 3D files
2020-03-19 Create directory for bearing mount 3D files
2020-03-19 Add 90 degree bearing mount 3D files
    [BearingMounts.scad, BearingMounts.stl]
2020-03-25 Added functionality for the overview page and started device control page
2020-04-05 Updated PCB files (fixed pi header traces)
    [GreenSenseCollabFinal.fzz]
2020-04-05 Updated PCB image (fixed pi header traces)
2020-04-09 Create frame image directory
2020-04-09 Add greenhouse frame pics
2020-04-09 Add greenhouse frame plans
2020-04-09 Create Frame Build Instructions
2020-04-09 Update Frame Build Instructions
2020-04-16 Image of daughterboard PCB
2020-04-17 Added stepper images
2020-04-17 Add bearing pictures
2020-04-17 Create Pi case image directory
2020-04-17 Add pi case and pcb images
2020-04-17 Add shutter servo image
2020-04-17 Add pump/reservoir images
2020-04-17 Add more pi case images
2020-04-17 Add stepper housing images
