Aidenbolos/Green-Sense/Images/Greenhouse Frame/GreenhouseFrameStep2.jpeg

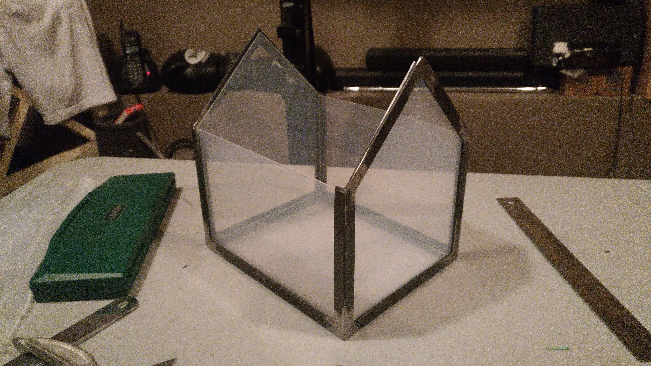
Images/Greenhouse Frame/GreenhouseFrameStep2.jpeg
